RemoteLabSydneyUni/PendulumRig/Documentations/Hardware/360x100_markup.pdf

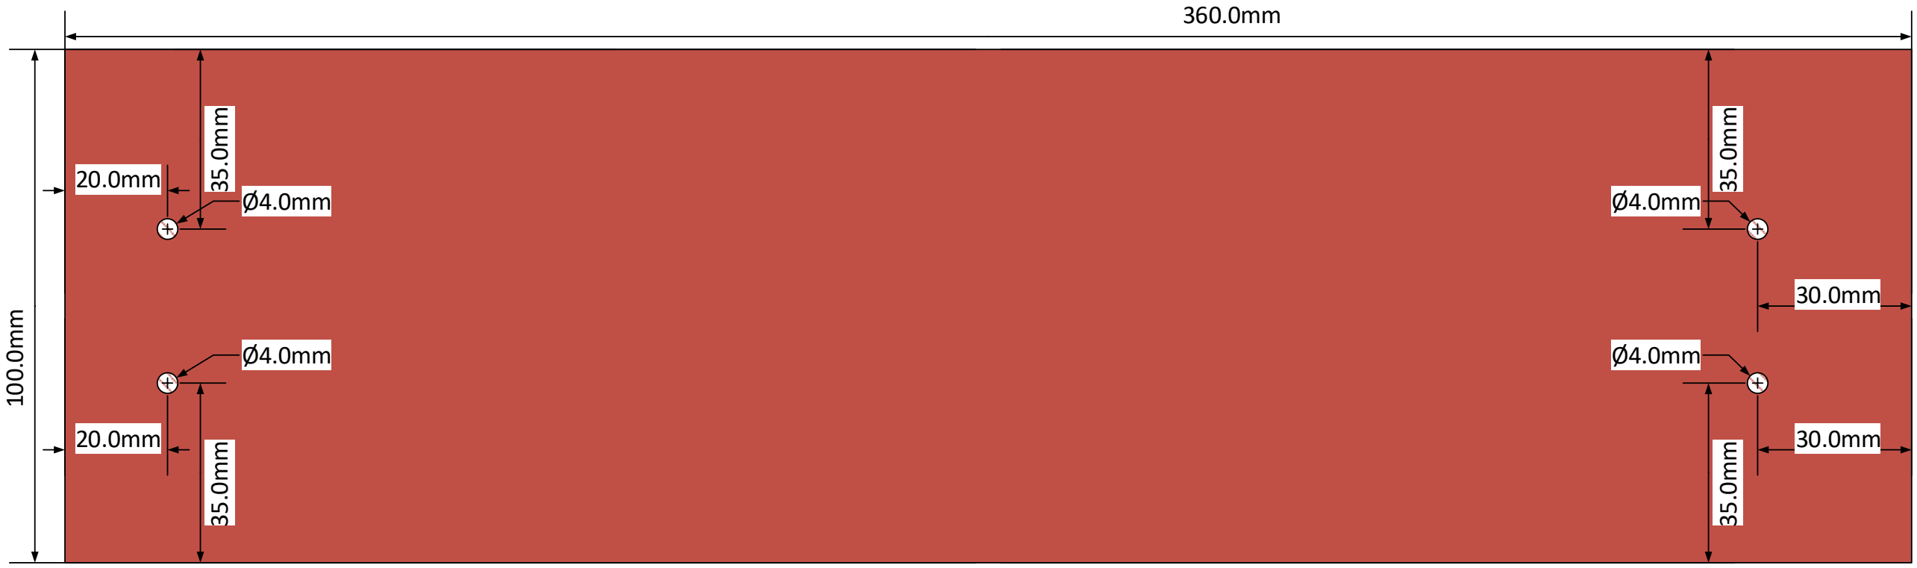
[picture p6: figure]
