RemoteLabSydneyUni/PendulumRig/Documentations/Circuit/Circuit Design.png

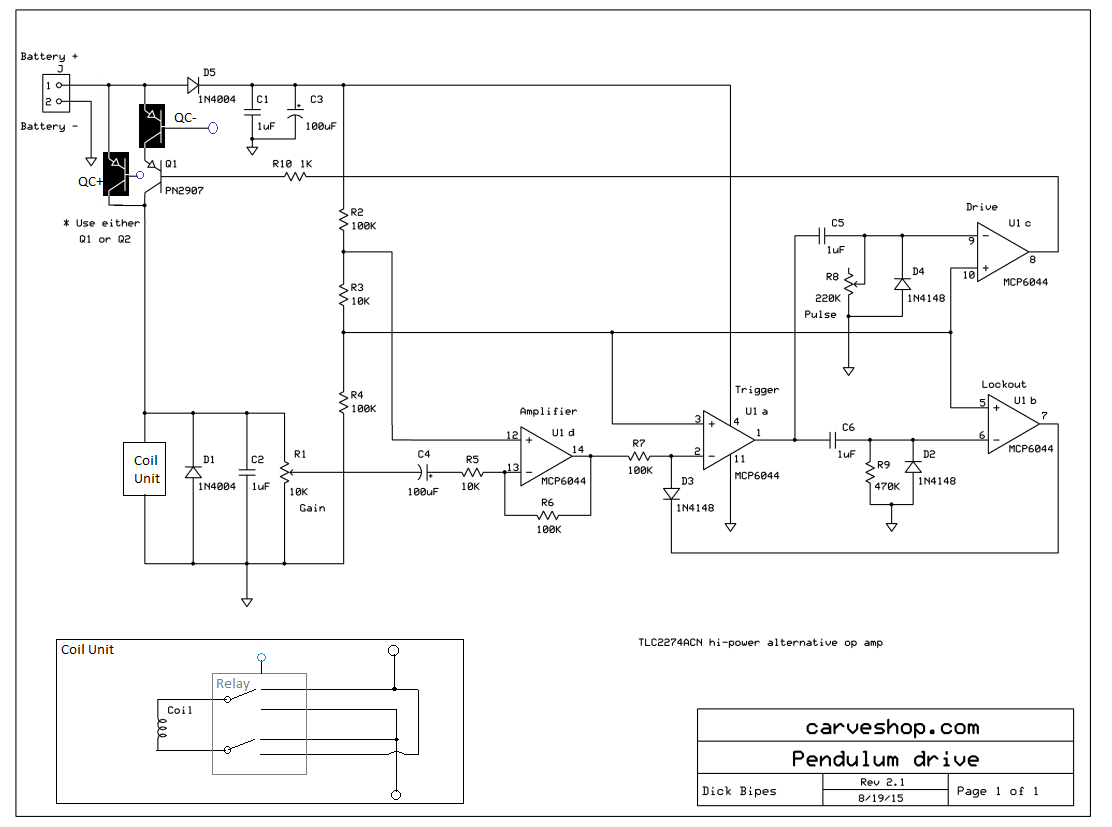
Documentations/Circuit/Circuit Design.png
