RemoteLabSydneyUni/PendulumRig/Documentations/Hardware/MotorSpec.jpg

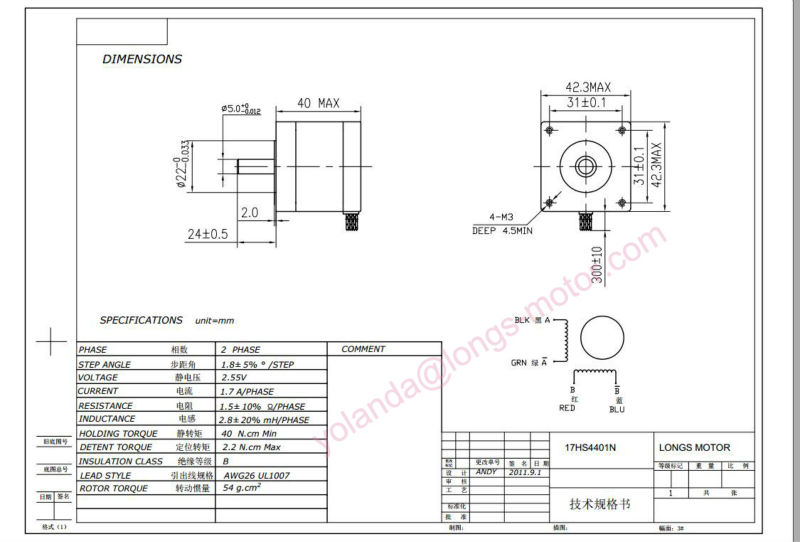
Documentations/Hardware/MotorSpec.jpg
