RemoteLabSydneyUni/PendulumRig/Documentations/Hardware/Item list.xlsx

Item No. | Color | Length (mm) | Width (mm) | Thickness (mm) | Quantities | DXF file | PDF file | Remarks
1 | Black | 500 | 200 | 6 | 1 | 500x200.dxf | 500x200_markup.pdf
2 | Black | 360 | 100 | 2 | 2 | 360x100.dxf | 360x100_markup.pdf
3 | Black | 400 | 300 | 2 | 1 | nil | nil | no holes/slots
4 | Transparent | 400 | 300 | 2 | 1 | nil | nil | no holes/slots
5 | Black | 400 | 300 | 6 | 1 | nil | nil | no holes/slots
