RemoteLabSydneyUni/PendulumRig/Documentations/Hardware/500x200_markup.pdf

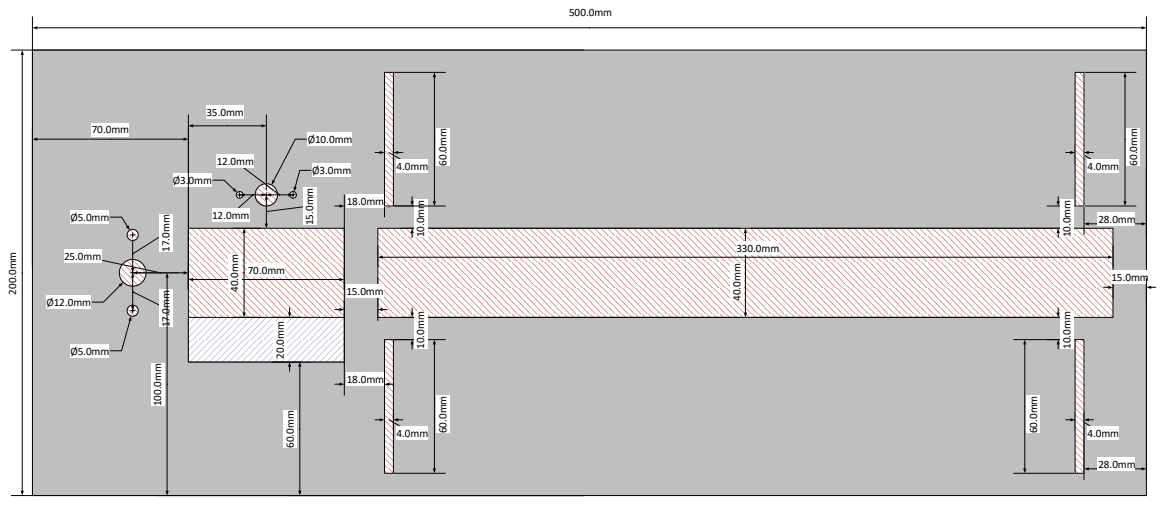
[picture p9: page 1]
0mm¹⁰.0mm
