RemoteLabSydneyUni/PendulumRig/(commit log)

2018-03-29 Commit 29/03/2018: Arduino control program V6.0
    [LastPosition.cfg]
2018-04-11 Update Documentations
    [Item list.xlsx]
